powellb1/CapStone/Documentation/Class Presentations/Design Presentation/photo 1.jpg

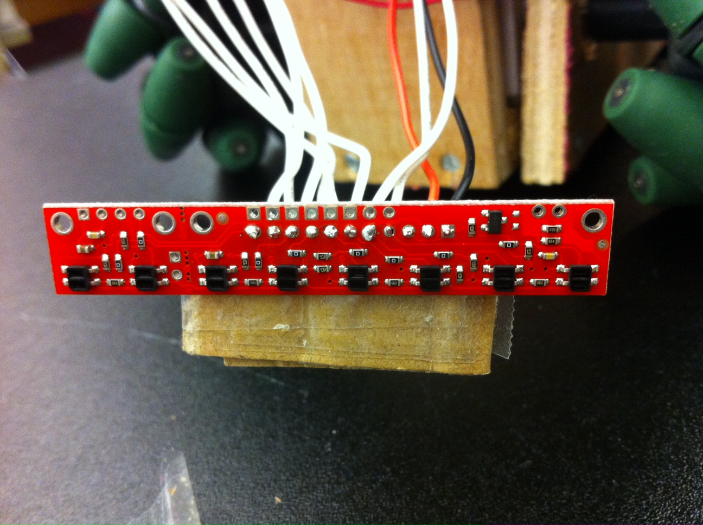
Documentation/Class Presentations/Design Presentation/photo 1.jpg
