powellb1/CapStone/Documentation/Class Presentations/Design Presentation/photo 2.jpg

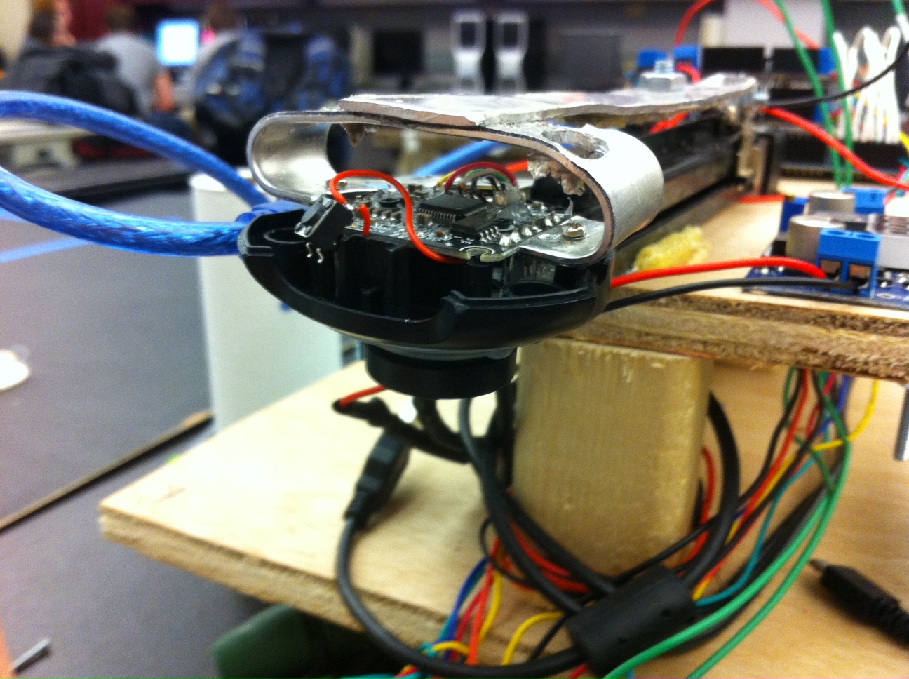
Documentation/Class Presentations/Design Presentation/photo 2.jpg
