powellb1/CapStone/README.md

CapStone
This is a test to see what happens on GitHub.
This is a test to see what happens on Brian's branch
========
