powellb1/CapStone/.c9/metadata/workspace/README.md

{"changed":true,"filter":false,"title":"README.md","tooltip":"/README.md","value":"CapStone\nThis is a test to see what happens on GitHub.\nThis is a test to see what happens on Brian's branch\nMore changes to the branch.\n========\n","undoManager":{"mark":72,"position":100,"stack":[[{"group":"doc",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
{"row":3,"column":15}},"text":"o"}]}],[{"group":"doc","deltas":[{"action":"insertText","range":{"start":{"row":3,"column":15},"end":{"row":3,"column":16}},"text":" "}]}],[{"group":"doc","deltas":[{"action":"insertText","range":{"start":{"row":3,"column":16},"end":{"row":3,"column":17}},"text":"t"}]}],[{"group":"doc","deltas":[{"action":"insertText","range":{"start":{"row":3,"column":17},"end":{"row":3,"column":18}},"text":"h"}]}],[{"group":"doc","deltas":[{"action":"insertText","range":{"start":{"row":3,"column":18},"end":{"row":3,"column":19}},"text":"e"}]}],[{"group":"doc","deltas":[{"action":"insertText","range":{"start":{"row":3,"column":19},"end":{"row":3,"column":20}},"text":" "}]}],[{"group":"doc","deltas":[{"action":"insertText","range":{"start":{"row":3,"column":20},"end":{"row":3,"column":21}},"text":"b"}]}],[{"group":"doc","deltas":[{"action":"insertText","range":{"start":{"row":3,"column":21},"end":{"row":3,"column":22}},"text":"r"}]}],[{"group":"doc","deltas":[{"action":"insertText","range":{"start":{"row":3,"column":22},"end":{"row":3,"column":23}},"text":"a"}]}],[{"group":"doc","deltas":[{"action":"insertText","range":{"start":{"row":3,"column":23},"end":{"row":3,"column":24}},"text":"n"}]}],[{"group":"doc","deltas":[{"action":"insertText","range":{"start":{"row":3,"column":24},"end":{"row":3,"column":25}},"text":"c"}]}],[{"group":"doc","deltas":[{"action":"insertText","range":{"start":{"row":3,"column":25},"end":{"row":3,"column":26}},"text":"h"}]}],[{"group":"doc","deltas":[{"action":"insertText","range":{"start":{"row":3,"column":26},"end":{"row":3,"column":27}},"text":"."}]}]]},"ace":{"folds":[],"scrolltop":0,"scrollleft":0,"selection":{"start":{"row":3,"column":27},"end":{"row":3,"column":27},"isBackwards":false},"options":{"guessTabSize":true,"useWrapMode":false,"wrapToView":true},"firstLineState":0},"timestamp":1410190207259}
