powellb1/CapStone/Documentation/Class Presentations/Are We There Yet Progress Report 5.pptx

## Are We There Yet

Progress Report 5

## Tasks Completed

- Post Mortem 3
- Sprint 4 Backlog
- Budget

## Currently Working On

- Prototyping

## Looking Ahead

- Prototype testing
- Prototype II
- Level 2 Requirements

## Prototype I

- Alex S. line following sensors
- Brian P. item detection with the camera
- Brian S. arm design and movement
- Michael P. Etch-A-Sketch software
