powellb1/CapStone/Documentation/Class Presentations/Are We There Yet Progress Report 4.pptx

## Are We There Yet

Progress Report 4

## Tasks Completed

- Post Mortem 2
- Sprint 3 Backlog
- Parts and design research

## Currently Working On

- Final Parts List and Budget
- Initial prototyping
- Parts order

## Current System Design

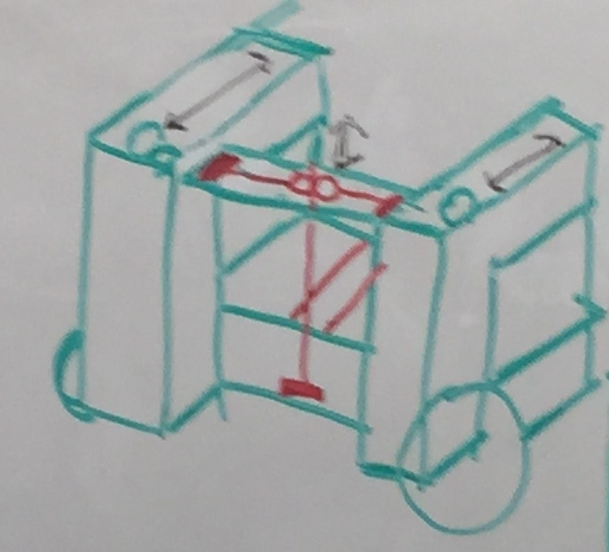
[picture p30: figure]

## Looking Ahead

- Parts Order
- Prototype
- Prototype testing
- Level 2 Requirements

## Major Budget Items

- Udoo Microcontroller
- Mecanum Wheels
- Stepper and gear motors
- Linear actuators
- Camera
- Chassis
- Batteries
