powellb1/CapStone/Documentation/Class Presentations/Are We There Yet Progress Report 4 Revision.pptx

## Are We There Yet

Progress Report 4

## Tasks Completed

- Post Mortem 2
- Sprint 2
- Budget
- Parts and design research

## Currently Working On

- Final Parts List
- Initial prototyping
- First parts order
  - Determine what we will prototype first

## Looking Ahead

- Parts Order
- Prototyping
- Prototype testing
- Level 2 Requirements

## Major Budget Items

- Udoo Microcontroller
- Mecanum Wheels
- Stepper and gear motors
- Linear actuators
- Camera
- Chassis
- Batteries
