powellb1/CapStone/Documentation/Class Presentations/Are We There Yet Progress Report 2.pptx

## Are We There Yet?

Progress Report #2

## Requirements Document Update

- SRS from initial review
- Items needing clarification:
  - Details on challenge completion

Notes: Challenge obstruction is a design consideration.

## Requirement Changes

- Initial Requirement
  - The system shall operate for a minimum of three consecutive course rounds each having duration of five (5) minutes, on one battery life.
- Edited Requirement
  - The system shall operate on one battery life for a minimum of three consecutive course rounds, each having duration of five (5) minutes.

## Requirements Needing Refinement

    - The system shall track its movement along the Scotch Blue Painter’s tape.
    - The system shall respond to the last color in the Simon within [TBD] amount of time.

## Next Steps

- Further research into design
  - Control boards
  - Overall system design
  - Method of challenge completion
- Specific parts research

## Questions?
