powellb1/CapStone/Documentation/Class Presentations/2014 SECON Competition Proposal.pptx

## 2014 SECON Competition Proposal

Are We There Yet? (AWTY)
Brian Sterling
Brian Powell
Alex Senopoulos
Michael Philotoff

## Competition Outline

- Line Following
- Simon Says (15 Seconds)
- Etch-A-Sketch (Draw IEEE)
- Rubik’s Cube (Rotate one side 180 degrees)
- Card Pick-up (Carry to end of course)

## Control System

- Arduino Mega
- Beaglebone Black
- Cortex Stellaris

Notes: Cortex line has a ton of pins on it along with around 4GB of onboard memory compared to the Arduino’s 128KB. We weren’t finding too much on the cortex products along with their respective IDEs. Beaglebone cloud 9 ide

## Movement System

- Tank treads*
- Wheels

Notes: Treads will allow for rotation without forward movement which will be helpful. It also allows for no worry about excess movemnt after motor stop. The resistance will halt it.

## Line Following

- Photo Resistors for recognition of line

## Simon Says

- Color Recognition
- Light Recognition
- Sound

Notes: Sound is probably going to be unreliable. Not safe to make that a primary method.

## Etch-A-Sketch

- Claws to manipulate knobs
- Cap to fit over knob in order to manipulate

## Rubik’s Cube

- Utilize same claw system as the etch-a sketch
- Attempt to leave on ground and manipulate top row

## Card Pick-Up

- Use of sticky tack or other adhesive substance
- Use of suction

Notes: Adhesive involves less manipulation on robots part.

## Initial Budget Estimate

- Claws: $40.00
- Microcontroller: $40.00 – $70.00
- Treads: $60.00
- Chassis: $50.00
- Arms: $60.00
- Motors : $10.00 per motor, approx.10-15 motors

Notes: $410. Conservative price

## Considerations

- Group Strengths
  - Line Following
  - Experience using microcontrollers and a variety of IDEs.
- Challenges
  - Exploration and learning of new topics/ideas, specifically the color/light recognition.
- Fall Goals
  - Etch-A-Sketch and Simon Says implemented

Notes: Brian got da experience line following. Good idea for it. Color recognition for the simon says is going to be a bigger challenge. Line Following will be continually looked at.
