powellb1/CapStone/Documentation/Class Presentations/Design Presentation/AWTY - Design Presentation.pptx

## Team Are We There Yet

Design Presentation

## Introduction

- Project Mission
  - Play the game “Simon” for 15 seconds
  - Pick up a playing card and carry it across the finish line
  - Twist one row of a Rubik’s cube 180 degrees
  - Draw “IEEE” on an Etch-A-Sketch
  - Line follow
  - Complete round in 5 minutes or less

## Competition Course


## Timeline

- 18 September 2014 – Preliminary Requirements
- 10 October 2014 – Preliminary Budget
- 18 November 2014 – Integrated Prototype
- 25 November 2014 – Revised Requirements
- 12 December 2014 – Preliminary Design Document

## Budget

- Proposed budget: $654.52
- Total spent: $560.21

## Design Solution

- Process
  - Identify when light in starting area goes out
  - Line follow to first challenge
  - Complete challenge
  - Line follow to second, third and fourth challenges, completing each
  - Cross finish line

## System Architecture


## Design Considerations

- Assumptions and dependencies
  - Operation
  - Rule changes
- General Constraints
  - Size
  - Power consumption
- Safety Constraints and Considerations
  - Electrical hazards
  - System heating

## Subsystems

- Coordination Subsystem
  - Reads input from sensors
  - Directs other subsystems
- Movement Subsystem
  - Contains all components responsible for moving system
- Challenge Subsystem
  - Contains all components responsible for completing challenges

## Coordination Subsystem

- Purpose
  - Progresses system through state diagram
  - “Master” of system
- Responsibilities
  - Read input from sensors
  - Interpret sensor reading
  - Activate corresponding subsystem


## Functional Diagram


## Parts List

- Raspberry Pi B+
- Arduino Mega 2560
- QTR-8A Line Sensor Array
- USB Camera
- Ultrasonic Sensor

## Movement Subsystem

- Purpose and Responsibility
  - Performs all movement operations
    - Motors and wheels
    - Chassis
- Constraints
  - Fit within starting area
  - Maintain contact with course floor

## Functional Diagram


## Parts List

## Chassis

- 2 tiers
- (weight)
- (dimensions)

## Motors

- Motor stuff

## Wheels

- Wheel stuff

## Battery

- Battery stuff

## Challenge Subsystem

## Functional Diagram


## Parts List

## Simon Interactor

- Information about interactor

## Rubik’s Cube and Card Interactor

- Information about interactor

## Etch-A-Sketch Interactor

- Information about interactor

## Video of Performance

## Semester Re-cap

- Accomplishments
- Goals for next semester
