powellb1/CapStone/Documentation/Budget/Motors Refernces and Pictures.docx

References

1) Introduction to Stepper Motors. (n.d.). Retrieved October 6, 2014, from http://www.omega.com/prodinfo/stepper_motors.html
2) RobotShop | Robot Store | Robots | Robot Parts | Robot Kits ... (n.d.). Retrieved October 1, 2014.
3) SparkFun Electronics. (n.d.). Retrieved September 29, 2014.
4) Firgelli Technologies - Micro Linear Actuators. (n.d.). Retrieved October 3, 2014.
5) Stepper motor|Stepping gearmotor wholesale|Stepping motor ... (n.d.). Retrieved October 2, 2014.

Images

Soyo SY42STH38-0406B Unipolar Stepper Motor

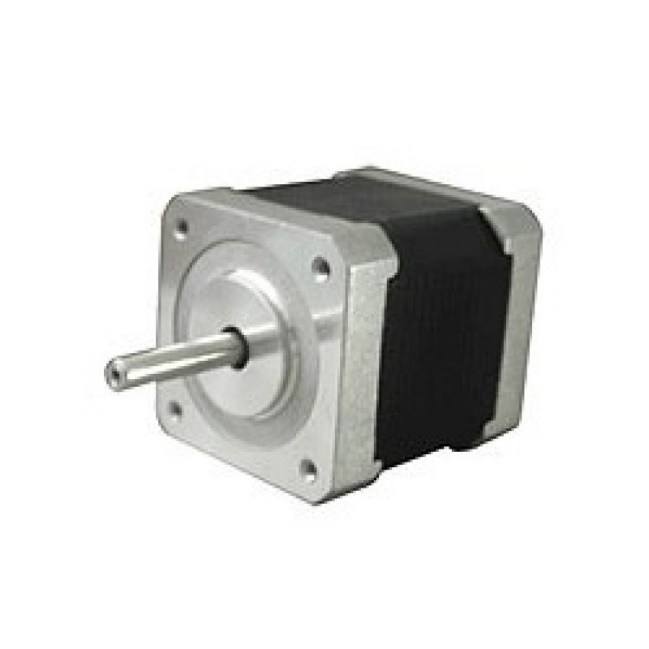
[picture p53: figure]
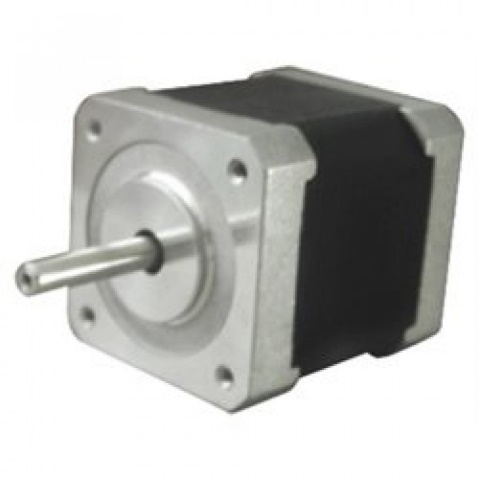
[picture p54: figure]

Soyo SY42STH47-1684MB RepRap Stepper Motor

Wantai 42BYGHM809

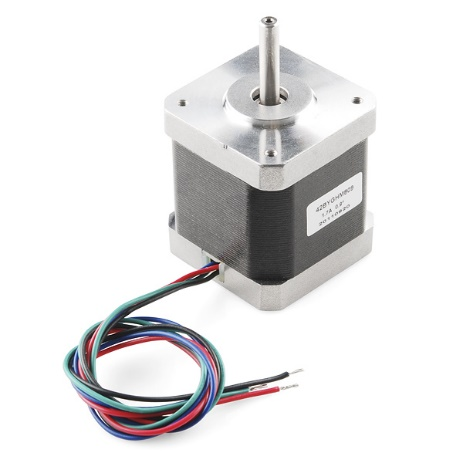
[picture p55: figure]
Stepper Motor - 68 oz.in (400 steps/rev)

Wantai 57BYGH420

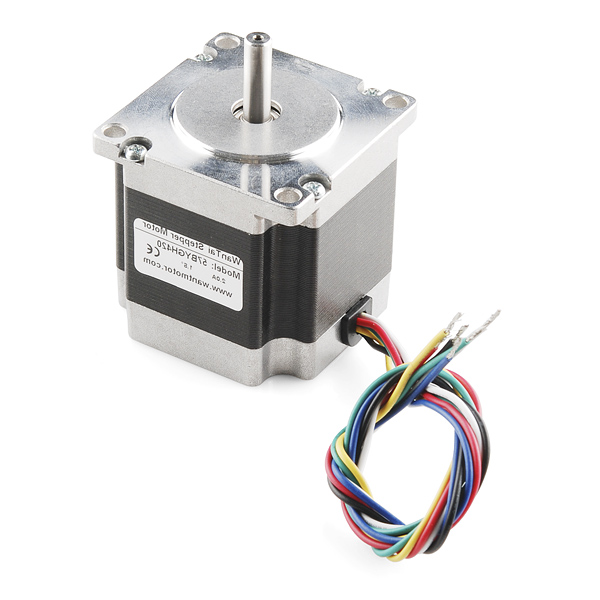
[picture p56: figure]
Stepper Motor - 125 oz.in (200 steps/rev)

Micro Metal Gearmotor 30:1 Shenzen Kenmore KM-12FN20-30-06430

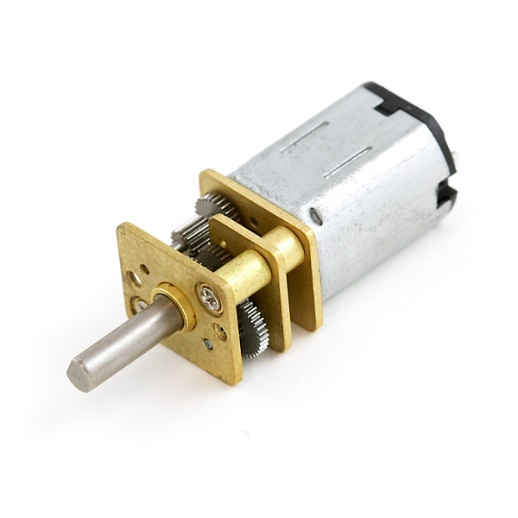
[picture p57: figure]
Micro Metal Gearmotor 30:1

Micro Gearmotor ROB-12285

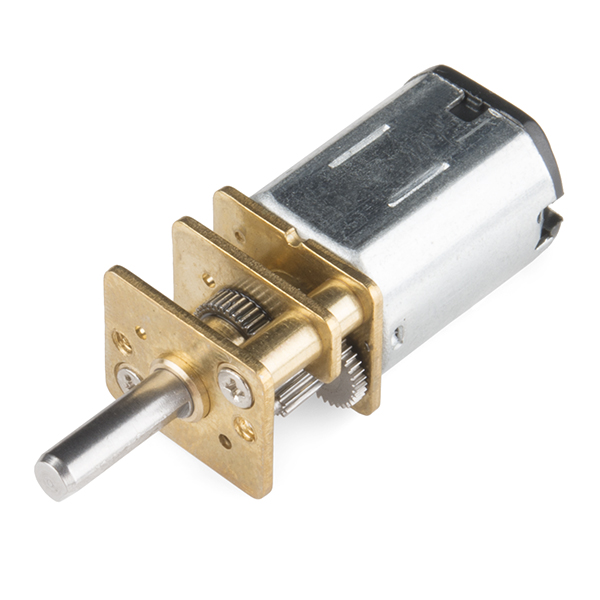
[picture p58: figure]
Micro Gearmotor - 90 RPM (6-12V)

Cytron 12V 12RPM 166oz-in Spur Gearmotor

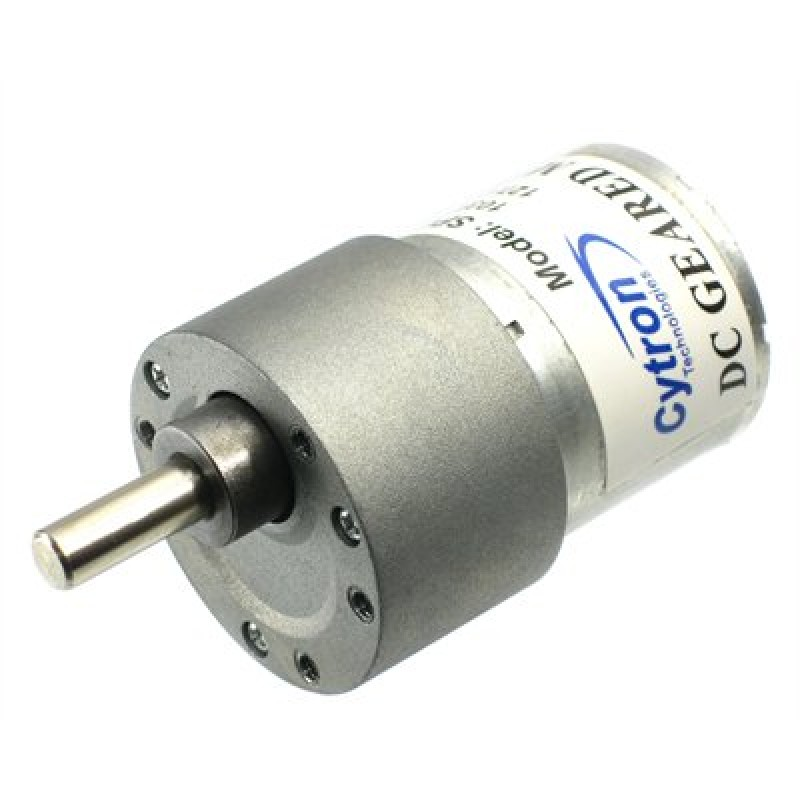
[picture p59: figure]

Firgelli Technologies L12 Actuator 50mm 210:1 12V Limit Switch

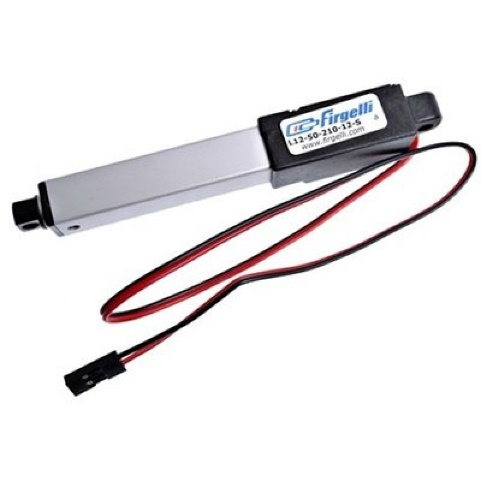
[picture p60: figure]

Firgelli Technologies L12 Actuator 100mm 100:1 12V Limit Switch

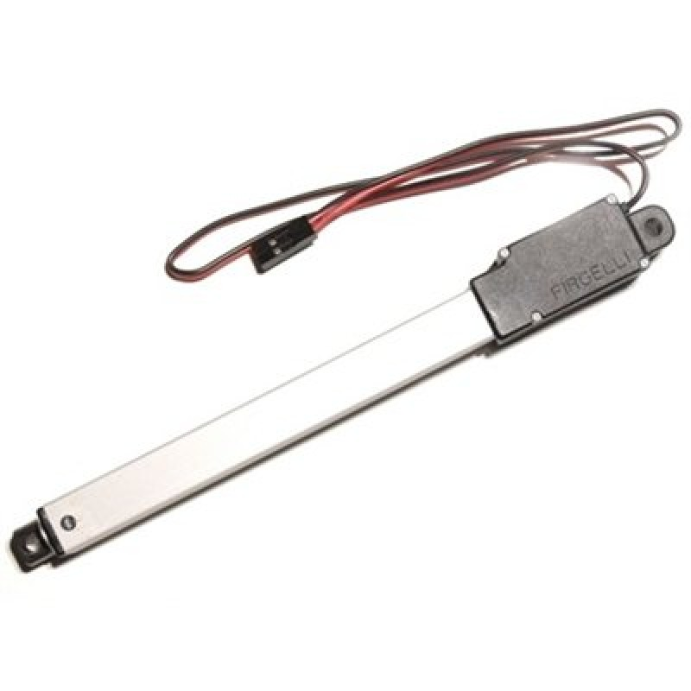
[picture p61: figure]

Firgelli Technologies L16 Linear Actuator, 140mm, 35:1, 12V w/ Limit Switches

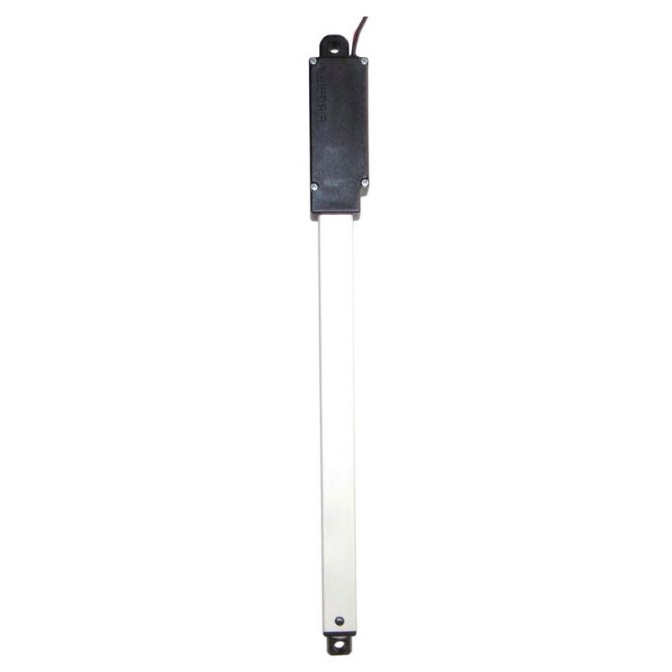
[picture p62: figure]
