powellb1/CapStone/Documentation/Class Presentations/Design Presentation/IMG_1001.jpg

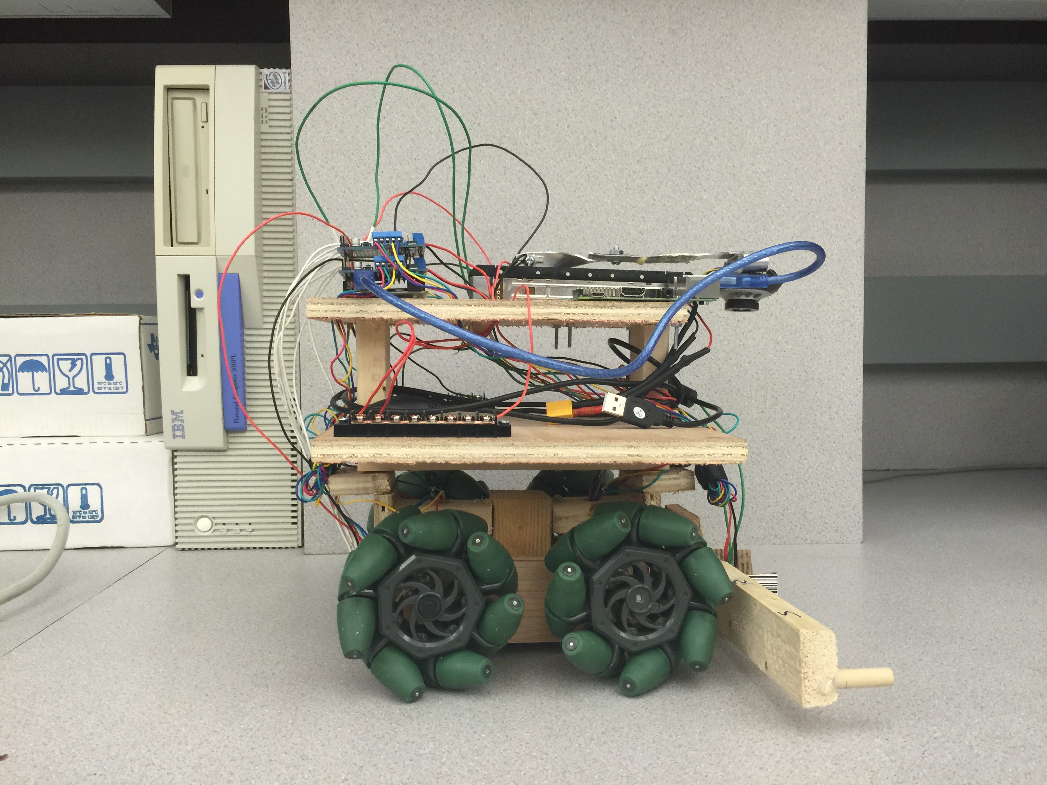
Documentation/Class Presentations/Design Presentation/IMG_1001.jpg
