powellb1/CapStone/Documentation/Class Presentations/Design Presentation/IMG_1002.jpg

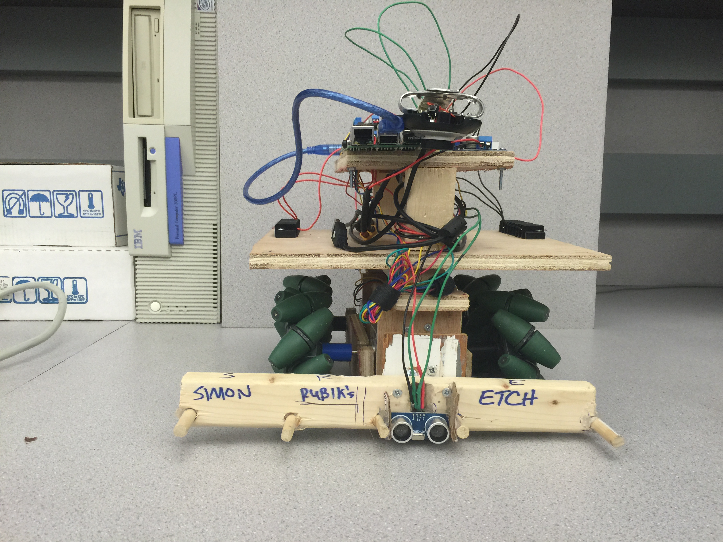
Documentation/Class Presentations/Design Presentation/IMG_1002.jpg
