powellb1/CapStone/Documentation/Class Presentations/Design Presentation/photo 3.jpg

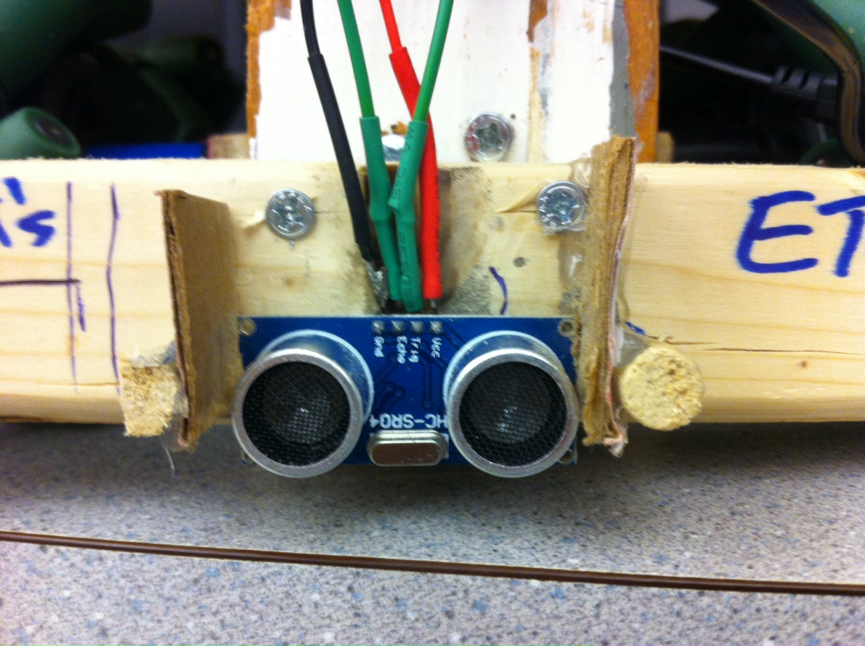
Documentation/Class Presentations/Design Presentation/photo 3.jpg
