powellb1/CapStone/Documentation/Design Drafts/RoadieDesignARev1 001.jpg

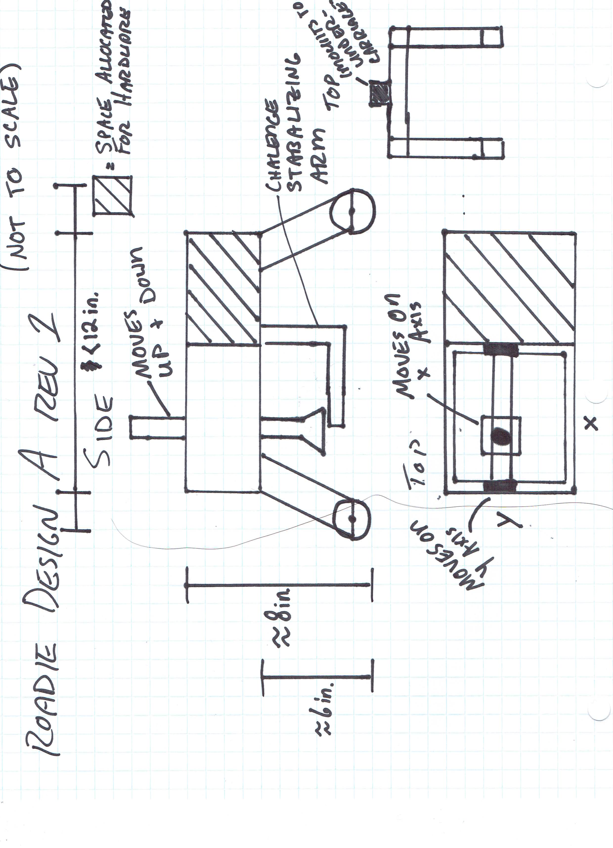
Documentation/Design Drafts/RoadieDesignARev1 001.jpg
