powellb1/CapStone/Documentation/Design Drafts/RoadieDesignBRev1 001.jpg

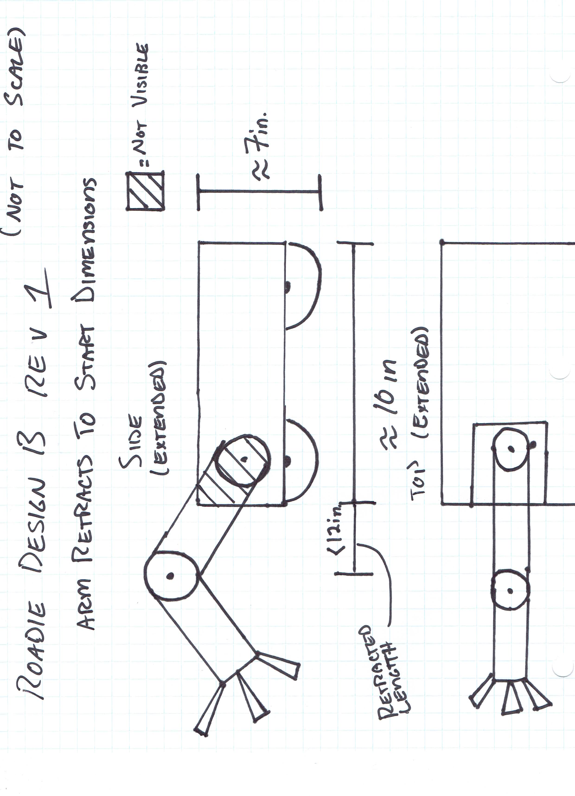
Documentation/Design Drafts/RoadieDesignBRev1 001.jpg
