powellb1/CapStone/Documentation/Budget/Parts Order.xlsx

Item | URL | Vendor | Item Price | Item Quantity | Shipping | Total
Udoo Quad | http://shop.udoo.org/usa/?___from_store=usa&popup=no | Udoo | $135 | 1 | $11.00 | $146.00
Mechanum Wheels | http://www.vexrobotics.com/276-1447.html | Vex Robotics | $59.99 | 1 | 11.72 | $71.71
Venom 800mAh LiPo | http://www.amazon.com/Venom-800mAh-LiPO-Battery-Plug/dp/B0027GEY3Y | Amazon | $13.99 | 1 |  | $13.99
Fosmon USB 6 LED Webcam | http://www.amazon.com/Fosmon-Webcam-Camera-Meeting-compatible/dp/B008GWPC1Q |  | $7.99 | 1 |  | $7.99
Venom 5000mAh LiPo | http://www.amazon.com/Venom-5000mAh-14-8-LiPO-Battery/dp/B0027G9F9M |  | $79.43 | 1 |  | $79.43
Firgelli 50mm Minature Linear Actuator | http://www.robotshop.com/en/firgelli-technologies-l12-actuator-50mm-210-1-6v-limit-switch.html | Robotshop | $70.00 | 2 | $9.00 | $149.00
Micro Gearmotor ROB-12285 | https://www.sparkfun.com/products/12285 | Sparkfun | $12.95 | 3 |  | $38.85
Wantai 42BYGHM80 Stepper Motor | https://www.sparkfun.com/products/10846 |  | $16.95 | 4 |  | $67.80
QRE1113 | https://www.sparkfun.com/products/9454 |  | $2.95 | 5 |  | $14.75
LiPo Fuel Gauge | https://www.sparkfun.com/products/10617 |  | $9.95 | 2 |  | $19.90
EasyDriver Stepper Motor Driver | https://www.sparkfun.com/products/10267 |  | $14.95 | 1 |  | $14.95
 |  |  |  |  | Total | $624.37
