powellb1/CapStone/Documentation/Budget/Final Budget.xlsx

Item | Vendor | Backup Vendor | Price | Quantity | Shipping Cost | Replacement Cost | Total
Udoo Quad | Udoo Shop |  | $135.00 | 1 | $11.00 |  | $146.00
Mechanum Wheels (4) | VEXRobotics |  | $59.99 | 1 | $11.72 |  | $71.71
QRE1113 (Digital) | SparkFun |  | $2.95 | 5 | $0.00 |  | $14.75
Venom 800mAh LiPo | Amazon |  | $13.99 | 1 | $0.00 |  | $13.99
Fosmon USB 6 LED Webcam | Amazon |  | $7.99 | 1 | $0.00 |  | $7.99
Custom Chassis | N/A |  | $25.00 | 1 | $0.00 |  | $25.00
Custom Claw | N/A |  | $40.00 | 1 | $0.00 |  | $40.00
Firgelli 50mm Miniature Linear Actuator | Robot Shop | Firgeli | $70.00 | 2 | $9.00 |  | $149.00
Micro Gearmotor ROB-12285 | SparkFun |  | $12.95 | 3 | $0.00 |  | $38.85
Wantai 42BYGHM80 Stepper Motor | SparkFun | Wantmotors | $16.95 | 4 | $0.00 |  | $67.80
Venom 5000 mAh LiPo | Amazon |  | $79.43 | 1 | $0.00 |  | $79.43
 |  |  |  |  |  | Total: | $654.52
