powellb1/CapStone/3D Parts/Wheel_cap_extended.stl

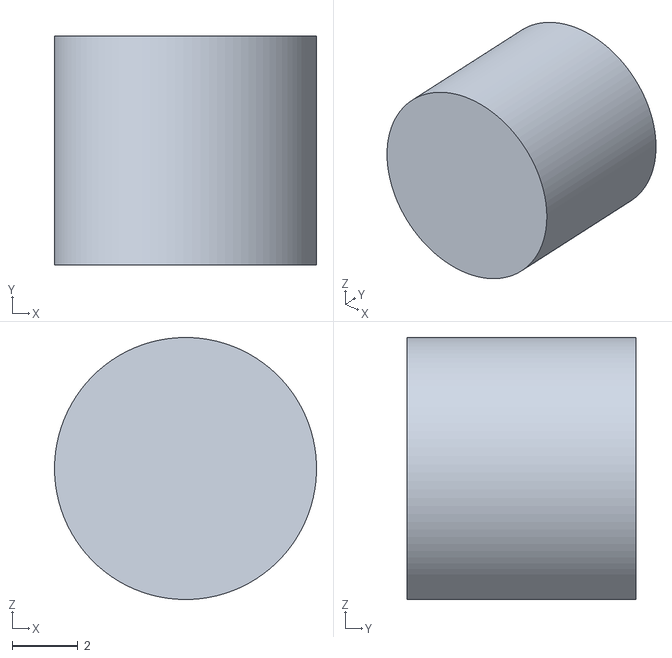
[picture p75: CAD file, 2014-12-03]
3D Parts/Wheel_cap_extended.stl
8.00 x 7.00 x 8.00
