powellb1/CapStone/3D Parts/Part1.stl

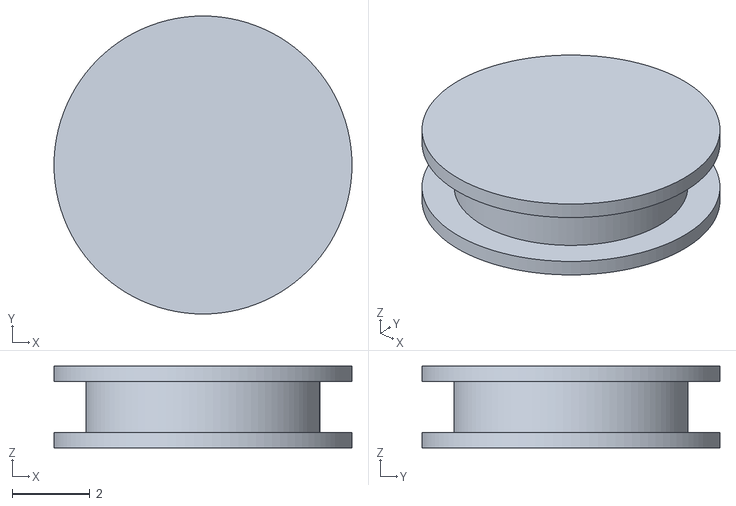
[picture p76: CAD file, 2014-11-17]
3D Parts/Part1.stl
7.65 x 7.65 x 2.10
