powellb1/CapStone/3D Parts/Wheel_Coupler_2.stl

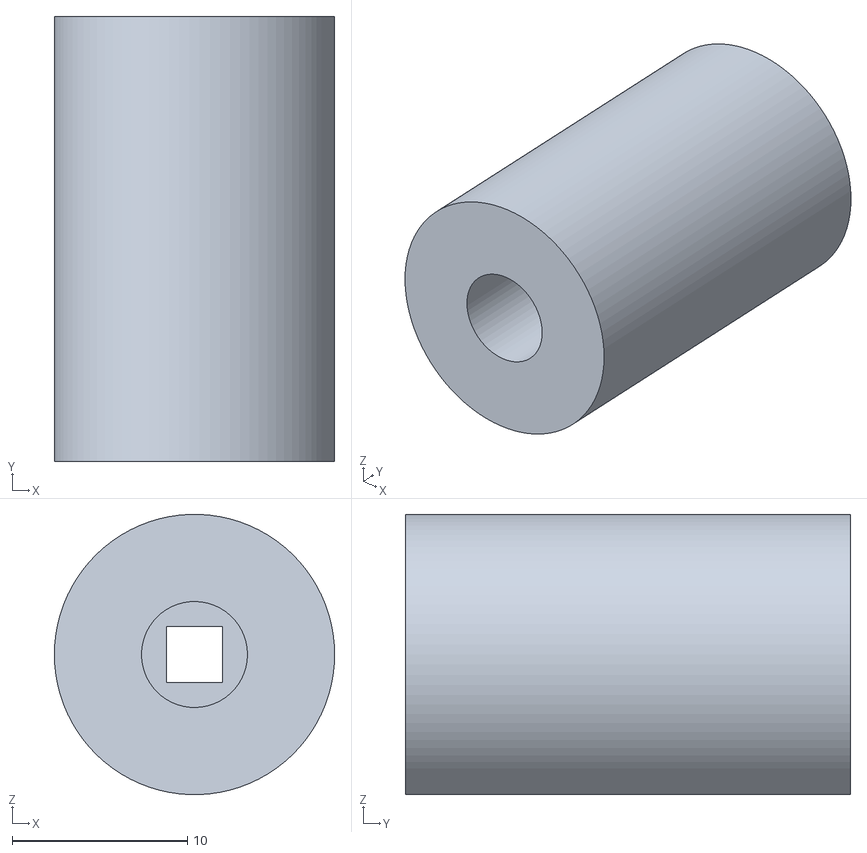
[picture p77: CAD file, 2014-11-14]
3D Parts/Wheel_Coupler_2.stl
16.0 x 25.4 x 16.0
