powellb1/CapStone/3D Parts/Wheel_cap.stl

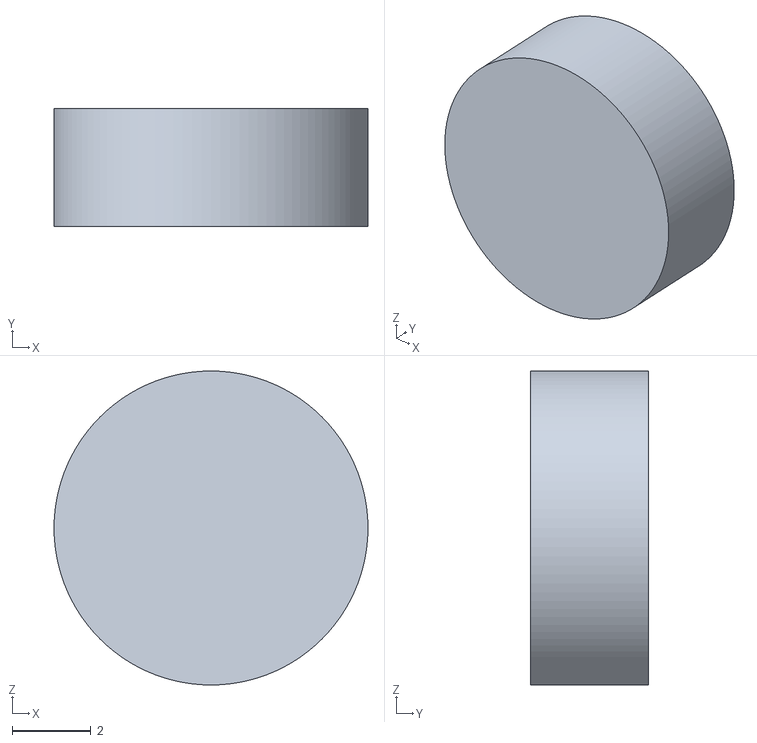
[picture p78: CAD file, 2014-11-10]
3D Parts/Wheel_cap.stl
8.00 x 3.00 x 8.00
