powellb1/CapStone/3D Parts/Wheel_Coupler.stl

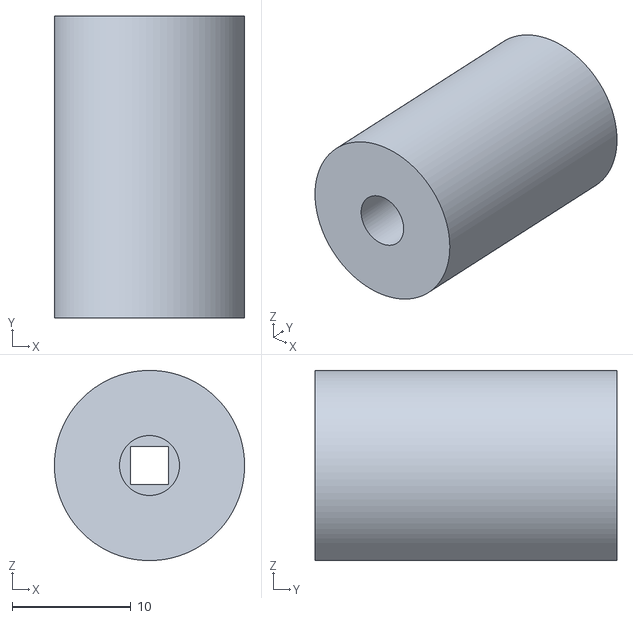
[picture p79: CAD file, 2014-11-10]
3D Parts/Wheel_Coupler.stl
16.0 x 25.4 x 16.0
