powellb1/CapStone/(list of files, cad)

Other CAD files:
3D Parts/OldVersions/Wheel_Coupler.0006.ipt
3D Parts/OldVersions/Wheel_cap.0003.ipt
3D Parts/OldVersions/Wheel_cap_extended.0001.ipt
3D Parts/Part1.ipt
3D Parts/Wheel_Coupler.dwg
3D Parts/Wheel_Coupler.ipt
3D Parts/Wheel_cap.ipt
3D Parts/Wheel_cap_extended.ipt
