powellb1/CapStone/Documentation/Design Documents/Movement-Misc_TestCases.xlsx

Project Name:
Test Case ID: |  |  |  | Test Design By: Alex Senopoulos
Test Priority: Low |  |  |  | Test Designed Date: November 29, 2014
Module Name: Movement |  |  |  | Test Excuted By:
Test Title: Sizing |  |  |  | Test Excution Date:
Description: Confirm size requirements for Roadie
Pre-conditions: Roadie will be motionless with it's camera retracted.
Requirement Satisfied: MOV 1
Step | Test Steps | Test Data | Expected Result | Actual Result | Status(Pass/Fail) | Notes
1 | Leave Roadie motionless
2 | Measure dimensions | Width/Length/Height | Within 1ft.x1ft.x1ft.
Post-conditions: Roadie will remain motionless
Test Case ID: |  |  |  | Test Design By: Alex Senopoulos
Test Priority: High |  |  |  | Test Designed Date: November 29, 2014
Module Name: Movement |  |  |  | Test Excuted By:
Test Title: Roadie stress test |  |  |  | Test Excution Date:
Description: Test life of Roadie's power to ensure at least 30 minute lifespan
Pre-conditions: Roadie will start suspended with no wheel contact on ground and a full battery charge. Modified code uploaded to keep motors and sensors coninually running.
Requirement Satisfied: MOV 2
Step | Test Steps | Test Data | Expected Result | Actual Result | Status(Pass/Fail) | Notes
1 | Suspend Roadie in place
2 | Run all subRoadies at normal operating capacity
3 | Measure time until noticible deterioration of wheel speed | Time (minutes) | Greater than 30 minutes
Post-conditions: Roadie power source will have a less than nominal charge.
Test Case ID: |  |  |  | Test Design By: Alex Senopoulos
Test Priority: Low |  |  |  | Test Designed Date: November 29, 2014
Module Name: Movement |  |  |  | Test Excuted By:
Test Title: Power switch |  |  |  | Test Excution Date:
Description: Ensure Roadie has easily accessible power switch
Pre-conditions: Roadie will be powered off at the starting area.
Requirement Satisfied: MOV 3
Step | Test Steps | Test Data | Expected Result | Actual Result | Status(Pass/Fail) | Notes
1 | Use power switch to provide power to Roadie |  | Roadie will receive power
Post-conditions: Roadie will have power and execute loaded Arduino instructions.
Test Case ID: |  |  |  | Test Design By: Alex Senopoulos
Test Priority: Medium |  |  |  | Test Designed Date: November 29, 2014
Module Name: Movement |  |  |  | Test Excuted By:
Test Title: Surface Contact |  |  |  | Test Excution Date:
Description: Ensure Roadie remains in contact with competition surface
Pre-conditions: Roadie will be un-powered at starting area
Requirement Satisfied: MOV 4, MOV 5
Step | Test Steps | Test Data | Expected Result | Actual Result | Status(Pass/Fail) | Notes
1 | Turn on Roadie
2 | Observe Roadie's exection of the competition from start to finish. |  | Roadie remains in contact with competition surface.
Post-conditions: Roadie is motionless at the finish line.
Test Case ID: |  |  |  | Test Design By: Alex Senopoulos
Test Priority: High |  |  |  | Test Designed Date: November 29, 2014
Module Name: Movement |  |  |  | Test Excuted By:
Test Title: Minimum oscillation line following |  |  |  | Test Excution Date:
Description: Ensure Roadie can efficiently follow straight guidance tape.
Pre-conditions: Roadie will be in a line following state with it's sensor array over straight guidance tape.
Requirement Satisfied:
Step | Test Steps | Test Data | Expected Result | Actual Result | Status(Pass/Fail) | Notes
1 | Allow Roadie to run continuously along guidance tape. |  | Roadie will keep guidance tape within the bounds of its own wheels.
Post-conditions: Roadie will arrive at the end of the guidance tape and have the tape between the bounds of the Roadie's wheels.
Test Case ID: |  |  |  | Test Design By: Alex Senopoulos
Test Priority: High |  |  |  | Test Designed Date: November 29, 2014
Module Name: Movement |  |  |  | Test Excuted By:
Test Title: Right turn |  |  |  | Test Excution Date:
Description: Ensure Roadie can navigate a right turn correctly
Pre-conditions: Roadie will approach a right turn in the guidance tape while in the line following state.
Requirement Satisfied:
Step | Test Steps | Test Data | Expected Result | Actual Result | Status(Pass/Fail) | Notes
1 | Roadie approaches right turn with sensors over guidance tape
2 | Roadie rotates leaves line following state and turns right 90 degrees | Angle of Roadie relative to new section of guidance tape | 10 degree margin of error
3 | Roadie resumes line following state
Post-conditions: Roadie will be in a line following state navigating along the guidance tape.
Test Case ID: |  |  |  | Test Design By: Alex Senopoulos
Test Priority: High |  |  |  | Test Designed Date: November 29, 2014
Module Name: Movement |  |  |  | Test Excuted By:
Test Title: Left turn |  |  |  | Test Excution Date:
Description: Ensure Roadie can navigate a left turn correctly
Pre-conditions: Roadie will approach a left turn in the guidance tape while in the line following state.
Requirement Satisfied:
Step | Test Steps | Test Data | Expected Result | Actual Result | Status(Pass/Fail) | Notes
1 | Roadie approaches left turn with sensors over guidance tape
2 | Roadie rotates leaves line following state and turns 90 degrees left | Angle of Roadie relative to new section of guidance tape | 10 degree margin of error
3 | Roadie resumes line following state
Post-conditions: Roadie will be in a line following state navigating along the guidance tape.
Test Case ID: |  |  |  | Test Design By: Alex Senopoulos
Test Priority: Medium |  |  |  | Test Designed Date: November 29, 2014
Module Name: Movement |  |  |  | Test Excuted By:
Test Title: Roadie veer too far right |  |  |  | Test Excution Date:
Description: Roadie corrects movement for being off the line too far to the right
Pre-conditions: Roadie is in the line following state with the two left most sensors over the guidance tape and the sensor array front facing away from the guidance tape.
Requirement Satisfied:
Step | Test Steps | Test Data | Expected Result | Actual Result | Status(Pass/Fail) | Notes
1 | Roadie adjusts right side motor speed to a larger value than the left side | Motor rpm values for each wheel | Right side motors = 5000, Left side motors = 2000
Post-conditions: Roadie's sensor array front will be facing towards the line
Test Case ID: |  |  |  | Test Design By:
Test Priority: |  |  |  | Test Designed Date:
Module Name: |  |  |  | Test Excuted By:
Test Title: |  |  |  | Test Excution Date:
Description:
Pre-conditions:
Requirement Satisfied:
Step | Test Steps | Test Data | Expected Result | Actual Result | Status(Pass/Fail) | Notes
Post-conditions:
Test Case ID: |  |  |  | Test Design By:
Test Priority: |  |  |  | Test Designed Date:
Module Name: |  |  |  | Test Excuted By:
Test Title: |  |  |  | Test Excution Date:
Description:
Pre-conditions:
Requirement Satisfied:
Step | Test Steps | Test Data | Expected Result | Actual Result | Status(Pass/Fail) | Notes
Post-conditions:
