powellb1/CapStone/Documentation/Design Documents/Coordination_TestCases.xlsx

Project Name:
Test Case ID: |  |  |  | Test Design By: Michael Philotoff
Test Priority: High |  |  |  | Test Designed Date: November 30, 2014
Module Name: |  |  |  | Test Excuted By:
Test Title: Idenfiting challenge in 10 seconds |  |  |  | Test Excution Date:
Description: Idenfity a challenge once arriving to that challenge zone within 10 seconds
Pre-conditions: Roadie arrives at a challenge zone
Requirement Satisfied: COR 6 and COR 6.1
Step | Test Steps | Test Data | Expected Result | Actual Result | Status(Pass/Fail) | Notes
1 | Turn on the ultra sonic |  | Ultra sonic operational
2 | Detect an object within 4 inches of Roadie | Object Detected | Detects an object
3 | Turns the camera on |  | Camera is operational
4 | Camera idenfitys the challenge within 5 seconds | Object Identification | Camera idenfities the object
Post-conditions: Idenfitys the challenge present infront of Roadie
Project Name:
Test Case ID: |  |  |  | Test Design By: Michael Philotoff
Test Priority: High |  |  |  | Test Designed Date: November 30, 2014
Module Name: |  |  |  | Test Excuted By:
Test Title: Rubik's Cube Identification and Alignment |  |  |  | Test Excution Date:
Description: Roadie correctly idenfities the challenge Rubik's Cube within 5 seconds of the camera being turn on. Then Roaide algins itself up with Rubik's Cube.
Pre-conditions: Roadie has arrvied at a challenge zone and has detected a challenge within 4 inches of Roadie
Requirement Satisfied: COR 6.3, COR 7, and COR 7.1
Step | Test Steps | Test Data | Expected Result | Actual Result | Status(Pass/Fail) | Notes
1 | Camera identifies Rubik's Cube |  | Rubik's Cube is identified
2 | Camera measures the distance between | Pixels convereted to inches | Distance measured
3 | Strafe the distance measured by the Camera |  | Roadie strafes
4 | Roadie moves forward 4 inches |  | Roadie moves forward
5 | Roadie signles that it has arrived at the challenge |  | Roadie is at the Rubik's Cube
Post-conditions: Roadie has aligned with the challenge and signles that it has arrived.
Project Name:
Test Case ID: |  |  |  | Test Design By: Michael Philotoff
Test Priority: High |  |  |  | Test Designed Date: November 30, 2014
Module Name: |  |  |  | Test Excuted By:
Test Title: Correctly Idenfity Simon Carabiner |  |  |  | Test Excution Date:
Description: Roadie correctly idenfities the challenge Simon Carabiner within 5 seconds of the camera being turn on. Then Roaide algins itself up with Simon Carabiner.
Pre-conditions: Roadie has arrvied at a challenge zone and has detected a challenge within 4 inches of Roadie
Requirement Satisfied: COR 6.2, COR 7, and COR 7.1
Step | Test Steps | Test Data | Expected Result | Actual Result | Status(Pass/Fail) | Notes
1 | Camera idenfities Simon Carabiner |  | Simon Carabiner is identified
2 | Camera measures the distance between Simon Carabiner and Roadie | Pixels convereted to inches | Distance measured
3 | Strafe this distance measured from the Camera |  | Roadie strafes
4 | Roadie moves forwards 4 inches |  | Roadie moves forward
5 | Roadie signles that it has arrived at the challenge |  | Roadie is at the Simon Carabiner
Post-conditions: Roadie has alligned with the challenge and signles that it has arrived at the challenge.
Project Name:
Test Case ID: Etch-A-Sketch Idenfitication and Algiment |  |  |  | Test Design By: Michael Philotoff
Test Priority: High |  |  |  | Test Designed Date: November 30, 2014
Module Name: |  |  |  | Test Excuted By:
Test Title: Correctly Idenfity Etch-A-Sketch |  |  |  | Test Excution Date:
Description: Roadie correctly idenfities the challenge Etch-A-Sketch within 5 seconds of the camera being turn on. Then Roaide algins itself up with Etch-A-Sketch.
Pre-conditions: Roadie has arrvied at a challenge zone and has detected a challenge within 4 inches of Roadie
Requirement Satisfied: COR 6.4, COR 7, and COR 7.1
Step | Test Steps | Test Data | Expected Result | Actual Result | Status(Pass/Fail) | Notes
1 | Camera idenfities Etch-A-Sketch |  | Etch-A-Sketch is identified
2 | Camera measures the distance | Pixels convereted to inches | Distance measured
3 | Strafe the distance measured from the Camera |  | Roadie strafes
4 | Roadie moves forward 4 inches |  | Roadie moves forward
5 | Roadie signles that it has arrived at the challenge |  | Roadie is at the Etch-A-Sketch
Post-conditions: Roadie has aligned with the challenge and signles that it has arrived at the challenge.
Project Name:
Test Case ID: Playing Card Idenfitication and Algiment |  |  |  | Test Design By: Michael Philotoff
Test Priority: High |  |  |  | Test Designed Date: November 30, 2014
Module Name: |  |  |  | Test Excuted By:
Test Title: Correctly Idenfity Playing Card deck |  |  |  | Test Excution Date:
Description: Roadie correctly idenfities the challenge Playing Card deck within 5 seconds of the camera being turn on. Then Roaide algins itself up with Playing Card deck.
Pre-conditions: Roadie has arrvied at a challenge zone and has detected a challenge within 4 inches of Roadie
Requirement Satisfied: COR 6.5, COR 7, and COR 7.1
Step | Test Steps | Test Data | Expected Result | Actual Result | Status(Pass/Fail) | Notes
1 | Camera idenfities Playing Card deck |  | Playing Card deck is identified
2 | Camera measures the distance | Pixels convereted to inches | Distance measured
3 | Strafe the distance measured from the Camera |  | Roadie strafes
4 | Roadie moves forward 4 inches |  | Roadie moves forward
5 | Roadie signles that it has arrived at the challenge |  | Roadie is at the Playing Card deck
Post-conditions: Roadie has aligned with the challenge and signles that it has arrived at the challenge.
