powellb1/CapStone/Documentation/Sprints/Sprint 3/Are We There Yet - Sprint 3 Postmortem.docx

Are We There Yet: Sprint 3 Postmortem

Planning Meeting

During the planning meeting, we constructed a back log from the items listed in the Budget Rubric that still need completing. From there, we assigned a perceived difficulty on a scale of one to five with one being trivial.

Task | Perceived Difficulty
Budget Preparation | 5
Formatting | 4
Requirements Traceability | 4
Parts Order | 2
Begin Prototyping | 3
Risk Analysis | 4

- We found that our research and initial budgets have been going well. We need to pick up the pace a little in order to have a good submission for 10/7
- We discussed what commitments we proposed during our postmortem. We have implemented a plan as to how we will meet our commitments. We also discussed how to improve the quality of our work.
- We discussed what we did wrong. We continue to recognize that we didn’t meet as often as we should.
- We discussed what we did well during the last sprint. We agree that we should try and meet more. We also found that we do need to improve some in the quality of work we have submitted.

Stand up logs

Date | Meeting Highlights
10/2 | - Sprint planning - Responsible for: - Alex: line following sensors, wheels - Brian P.:camera, chassis, claw - Brian S. : DC motor, linear actuator, servo - Michael: Microcontroller, battery
10/3 | New: - Michael: Microcontroller and Batteries progress on equations - Alex: Line Following and Movement progress decision matrices - Brian S: Motors decision matrices - Brian P. : Requirements traceability started for camera Issues: Format needs to consistent across all sections For next meeting: Common format for all sections and risk analysis
10/4 | New: - Michael: Risk analysis done for microcontroller - Alex : Risk analysis done for lin following - Brian S. : Risk analysis done for DC motors - Brian P: Risk analysis done for camera, arm Issues: Make sure deadlines are met. Some sections are behind on their expect progress. For next meeting: All of the budget sections need to be submitted to Brian P. for final assembly.
10/6 | New: All sections (Decision matrix, risk analysis and requirements traceability) have been completed for each component. Issues: Formatting. Formats wildly vary from section to section. All tables need lead ins and captions. For next meeting: Rough draft of budget needs to be done so that revisions can be made before submission on 10/7.
10/7 | New: Budget has been assembled into one document. It needs a lot of reworking in order to be ready for submission tonight. Responsibilities: - Brian P. - Make sure the claw, chassis and camera have equations to show quantitative analysis. Formatting - Michael - Battery calculations need explaining. Make sure all sections of the microcontroller and battery have equations. - Alex - Line following sensors and wheels need calculations. - Brian S. - Decision matrices for linear actuators. Issues: Budget was not prepared in time. We need to learn better.
10/9 | New: We have the ability to re-submit budget. Each member needs to take their section and revise it. Issues: From the initial submission, these need fixing: - Battery calculations need explaining - Page numbers aren’t correct - Consistent captions For next meeting: Have sections ready to go.
10/10 | New: Sections that still need fixing: - Battery - Actuators As a group we’ll go over what needs to be changed in these sections and why. Issues: Need to submit the budget tonight. Needs to be proofread.
10/14 | New: Dole out prototyping responsibilities: - Brain P: computer vision - Michael : Simulate IEEE on Etch-A-Sketch - Alex : Line following - Brian S. : Arm design Issues: No issues to report. For next meeting: Report on initial prototyping research

What Went Well

During Sprint 3, communication amongst our team went well. We all knew when the meeting were and what was to be discussed during the meeting. After the meeting, we all left knowing what needed to be done and when the due date was.

Additionally, our team frequently updated GitHub. This allowed us to all have current documents for editing and revisions. This showed us the progress that had been made, and allowed us to track progress on large tasks. By doing so, it allowed us to better plan for the budget in the coming weeks.

What Could Use Improvement

While we knew that style and format needed improvements from the last sprint, we failed to plan for it in this sprint. For larger documents, we need to plan for common formats and styles during the beginning stages so that merging parts isn’t as much of a hassle.

We managed to iron down meeting times and meet many times during this sprint. There were times however, when we need to realize when a stand-up meeting with a time-box versus a work meeting is necessary as to not waste time.

Although we did plan a schedule for delivering the budget artifact on time, we vastly underestimated the work of formatting and proofreading the entire document. This needs to be considered for future artifacts.

Our Commitments This Next Sprint

Since we have now placed our parts order the next step is the prototyping process. We will each be taking a section of the robot and creating a working prototype in the upcoming sprint. The prototype responsibilities are as follows:

- Brian P. - object recognition/detection
- Michael - Etch-A-Sketch simulation
- Alex - line following
- Brian S. - arm prototype

As prototyping will consume most of the next sprint, it is what we have most of our time allotted to.

Additionally, we will be committed to maintaining our effective communication skills that we exhibited during this sprint. We also need to plan better for what is coming due. This was a large lesson learned, and one that will not soon be forgotten.

Retrospective

Looking back to Sprint 2, we have met most of the commitments that we proposed. During Sprint 2, we began to focus more and hone in on one design, which helped in guiding us towards the correct parts to use. During Sprint 3, we were able to refine the design proposed in Sprint 2 to help with a more concise budget and parts order. The budget and parts order has guided us towards the prototypes that will be needed during this next sprint. This is due to the fact that some of the parts that we had initially thought may work, did not turn out as expected when performing our decision matrices.

As noted in Sprint 2, for the most part, we were able to submit all documents on time and with quality we are proud of. As we noted, we lagged a little with our budget document, but we have learned from this mistake and we will not make that error again. Additionally, we still need to improve meetings. This is especially true as we move into prototyping. This is because as we begin to get into prototyping, we will need to rely on each others skills and abilities more, thereby making the frequency with which we meet an important factor to improve upon.
