powellb1/CapStone/Software/ComputerVision/slidePot_move/Motor_shield_demo_code/Motor_shield_demo_code.ino

//. Motor driver shield- 2012 Copyright (c) Seeed Technology Inc.
// 
//  Original Author: Jimbo.we
//  Contribution: LG
//  
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
int pinI1=8;//define I1 interface
int pinI2=11;//define I2 interface 
int speedpinA=9;//enable motor A
int pinI3=12;//define I3 interface 
int pinI4=13;//define I4 interface 
int speedpinB=10;//enable motor B
int spead =255;//define the spead of motor
 
void setup()
{
  pinMode(pinI1,OUTPUT);
  pinMode(pinI2,OUTPUT);
  pinMode(speedpinA,OUTPUT);
  pinMode(pinI3,OUTPUT);
  pinMode(pinI4,OUTPUT);
  pinMode(speedpinB,OUTPUT);
}
 
void forward()
{
     analogWrite(speedpinA,spead);//input a simulation value to set the speed
     analogWrite(speedpinB,spead);
     //digitalWrite(pinI4,HIGH);//turn DC Motor B move clockwise
     //digitalWrite(pinI3,LOW);
     digitalWrite(pinI2,LOW);//turn DC Motor A move anticlockwise
     digitalWrite(pinI1,HIGH);
}
void backward()//
{
     analogWrite(speedpinA,spead);//input a simulation value to set the speed
     analogWrite(speedpinB,spead);
     //digitalWrite(pinI4,LOW);//turn DC Motor B move anticlockwise
     //digitalWrite(pinI3,HIGH);
     digitalWrite(pinI2,HIGH);//turn DC Motor A move clockwise
     digitalWrite(pinI1,LOW);
}
void left()//
{
     analogWrite(speedpinA,spead);//input a simulation value to set the speed
     analogWrite(speedpinB,spead);
     digitalWrite(pinI4,HIGH);//turn DC Motor B move clockwise
     digitalWrite(pinI3,LOW);
     digitalWrite(pinI2,HIGH);//turn DC Motor A move clockwise
     digitalWrite(pinI1,LOW);
}
void right()//
{
     analogWrite(speedpinA,spead);//input a simulation value to set the speed
     analogWrite(speedpinB,spead);
     digitalWrite(pinI4,LOW);//turn DC Motor B move anticlockwise
     digitalWrite(pinI3,HIGH);
     digitalWrite(pinI2,LOW);//turn DC Motor A move clockwise
     digitalWrite(pinI1,HIGH);
}
void stop()//
{
     digitalWrite(speedpinA,LOW);// Unenble the pin, to stop the motor. this should be done to avid damaging the motor. 
     digitalWrite(speedpinB,LOW);
     delay(1000);
 
}

void loop()
{
  forward();
  delay(1000);
  backward();
  delay(1000);
}
