powellb1/CapStone/(commit log)

2014-09-08 Updated PowerPoint
2014-09-13 Add parts to sequence diagrams
    Also, change some parts to the use case, added bad state and good state
    to the glossary... For the third sequence diagram I cant center it on
    the page maybe you can, I tried cutting it out and pasting it again to
    see if that worked, but it didn't.
2014-09-18 use cases
    add the 6th use case and fixed the other use cases, also added in two
    words to the glossary and edit a few words in the glossary
2014-09-18 use case stakeholder updated
    added in the ECSSE and IEEE to each of the use cases, sequence diagrams
    save file got messed up so I'm rebuild each one of them so I'll have
    then done by noon tomorrow at the latest
2014-09-18 Requirements
    Fixed use case formatting. Changed weird requirements.
2014-09-19 Requirements.
    Added periods to the end of use case sentences.
2014-10-01 Movement budget
    Wheel justifications and decision matrix
2014-10-04 Chassis Budget
    Rough outline of chassis budget. More of a means to get thoughts down.
2014-10-04 batteries and microcontroller updated
    split the batteries into two sections one for motors the other for
    micorcontroller. also added in risk and environment factors for
    batteries. Microcontroller added three tables description, processing
    power, and memory. description still needs to be finished along with
    memory. Also batteries still need finish the desicion matrix and pick
    out batteries for the motors
2014-10-04 Claw Budget
    Added in claw budget. Still needs some refinement. 90% there.
2014-10-05 Claw and Chassis budget.
    Claw budget has been finalized. The chassis budget is missing
    information on the cost of the custom chassis. Tomorrow the requirements
    traceability and the risk analysis sections will be added.
2014-10-05 Claw, Arm and Chassis
    Incremental commit of claw and chassis budgets. The arm budget has all
    the necessary components for merging into final budget.
2014-10-06 Line Following and Movement
    Requirements Traceability added
2014-10-06 Camera and Chassis.
    Camera and chassis are 95% done. Need confirmation from Jorge on some
    questions I asked him before they can be marked as complete. More
    specifically, in the instance where the robot would literally fail
    (camera stops), what do we put as our mitigation plan?
2014-10-06 Motors Budget
    Motor Budget for the steppers and the gearmotors. Still working on
    section for the linear actuator and risk analysis. References and
    pictures in a separate document
2014-10-06 Motor Budget and Pictures and Refernces
    Missing Risk Analysis
2014-10-07 Motor Budget
    Complete motor budget with risk analysis and requirements traceability.
    Added table description below each table. Every table is labeled (Table
    ?) in the text and Table ?: for the table comments
2014-10-07 Final Budget v1
    Initial commit of budget. Still need to add in motors, movement and
    claw. References need to be added as well as pictures. The risk section
    for camera and battery need to be finalized.
2014-10-07 Final budget v2
    Copied over motor section. Formatting still needed. Will resume in the
    morning.
2014-10-07 Final Budget v3
    All pieces are assembled into the final budget. REFERENCES AND PICTURES
    ARE NOT IN THE BUDGET AS OF YET. Major formatting issues have been
    resolved. Motor section and line following section need some tweaking
    still. Additionally, each section will have a summary. This still needs
    to be implemented.
2014-10-07 Final Budget V4
    Camera section is finished. Small formatting changes.
2014-10-07 Budget V6
    Updated budget to include references for chassis, camera and arm.
2014-10-08 Budget updates
    Updated references for claw, chassis and camera.
2014-10-08 Final Budget
    Budget table ready to be plopped into word.
    [Final Budget.xlsx]
2014-10-08 Final Budget Update
    Updated columns and numbers
    [Final Budget.xlsx]
2014-10-08 Updated final budget
    Motors updated. Regerences updated
2014-10-08 Parts order
    Initial commit to github.
    [Parts Order.xlsx]
2014-10-08 Added LiPo Fuel Gauges
    these were the only ones i could find
    [Parts Order.xlsx]
2014-10-08 MotorDriver
    Stepper motor driver added
    [Parts Order.xlsx]
2014-10-09 Budget Doc update
    Updated formatting and spelling of budget doc
    [Parts Order.xlsx]
2014-10-10 Budget update
    Updated battery section of budget.
2014-10-20 Progress report 5
    deals with the prototypes due in a week, also I forgot what Brian S. is
    prototyping so if you could just add that in that would be great
2014-10-26 Adding in CV software. The software includes a CPP file and an Arduino File. The Arduino will accept serial data and react depending upon the information coming in. Once it is done, it sends confirma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
2014-10-27 Linefollow code
    Code updated with PID library and average of QREs.
2014-10-27 PID corrections
    Linefollow software
    [UdooSoftware.ino]
2014-10-31 Software and postmortem grammar
    Software syntax updates as usual along with some short postmortem
    grammar fixes
    [UdooSoftware.ino]
2014-11-03 Sensor array and new basic line following code
    -QTR code is basic sensing code.
    -LineFollowing includes the QTR code plus PID code. pidOutput needs to
    interact with motors.
2014-11-06 3D Parts and Stepper Motor Code
    Added 3D parts for the wheel coupler and wheel cap. Added in sample
    stepper motor code.
    [Wheel_Coupler.ipt, Wheel_Coupler.stl, Wheel_cap.ipt, Wheel_cap.stl]
2014-11-08 Refined 3D Parts
    [Wheel_Coupler.0002.ipt, Wheel_Coupler.dwg, Wheel_Coupler.ipt, Wheel_Coupler.stl, Wheel_cap.0001.ipt, Wheel_cap.ipt, Wheel_cap.stl]
2014-11-09 Adding new changes to Computer Vision that reflect where the camera is mounted on the robot
2014-11-09 3D Part Updates
    Updated the parts for the wheel coupler
    [Wheel_Coupler.0002.ipt, Wheel_Coupler.0003.ipt, Wheel_Coupler.ipt, Wheel_Coupler.stl]
2014-11-10 3D Parts Update
    Updated 3D parts to reflect width changes,
    [Wheel_Coupler.0003.ipt, Wheel_Coupler.0005.ipt, Wheel_Coupler.ipt, Wheel_Coupler.stl, Wheel_cap.0001.ipt, Wheel_cap.0003.ipt, Wheel_cap.ipt, Wheel_cap.stl]
2014-11-12 Update to last working Object Detection
    Uploading working camera code
2014-11-13 Committing updated contours and arduino sketch. Ardunio sketch works with range sensor and turning off camera. Will test tomorrow with motor shield.
2014-11-13 Late code changes
    Line following code includes additions for stepper integration.
2014-11-13 Post Mortem 5
    Uploaded post mortem 5.
    [Wheel_Coupler.0005.ipt, Wheel_Coupler.0006.ipt, Wheel_Coupler.ipt, Wheel_Coupler_2.stl]
2014-11-14 Fixed momemnts_cam_demo.cpp so that it will compile on Pi.
    [objectDetection.ino]
2014-11-15 Uploaded working range and image detection. The arduino can correctly sense when an image is near. It communicates to the Pi once the challenge is complete to turn off the camera.
    [objectDetection.ino]
2014-11-15 Added in turning and auto correction
    [LineFollowing.ino]
2014-11-16 Vision software successfully talks to the arduino to turn the camera off and on as well as to shuffle.
2014-11-16 Camera software works. It is ready to go for integration tomorrow. Working on turning Arduino code into a library for ease of use.
2014-11-17 Arduino Libraries
    Created an object detect library for Arduino for ease of implementation.
    [Part1.ipt, Part1.stl]
2014-11-18 Prototype 2
    Added in prototype 2 report.
2014-11-22 Level 2 Requirements
    Challenge and Movement Systems need their traceability matrices
    completed. All sections need sequence diagrams. Challenge and movement
    systems need use cases. Challenge and movement systems also might need
    more requirements.
2014-11-24 LineFollowing Code
    New code includes Mike's movement code. The script uses leftSideSpeed
    and rightSideSpeed static global variables to utilize the PID outputs.
2014-11-24 Level 2 Requirements
    Added traceability matrices for movement and challenges
2014-11-24 Level 2 Requirements
    Made some format changes. Grammar fix for traceability matrices
2014-11-25 Use cases updated
    Redid the use case from the challenge section and added in use case from
    the movement section.
2014-11-25 updated the extentsions and removed the full movement use case
    Removed the full movement use case because there is already one located
    in section 4.
2014-11-25 Common Libraries and Strafe code
    Strafe script added that includes function to strafe based off inches
    provided.
    Common Libraries folder added so we're all on the same page. Currently
    includes AFMotor, AccelStepper, QTRSensors, and PID
    [project.cfg]
2014-11-29 Test case stuff
    [TestCaseTemp.xlsx]
2014-11-30 Extended wheel caps
    [Wheel_cap_extended.0001.ipt, Wheel_cap_extended.ipt]
2014-11-30 uploading test case stuff
    [TestCaseTemp.xlsx]
2014-11-30 Design Document
    Added in System Design diagram as well as completed most of system
    overview. Need to finish system design.
    [Responsibilities.xlsx]
2014-11-30 First Movement/Misc Tests
    [Movement-Misc_TestCases.xlsx]
2014-11-30 coordination system test cases
    not finished
    [Coordination_TestCases.xlsx]
2014-12-02 Design Document
    Changed system design around.
    [Responsibilities.xlsx]
2014-12-02 Movement/Misc Test cases
    Movement and misc test cases should be complete. All movement
    requirements covered along with many lower level tests.
    [Movement-Misc_TestCases.xlsx]
2014-12-02 SDS quick edit
    Just quick things that popped out. No major changes.
    [TestCaseTemp.xlsx]
2014-12-03 STL Files for 3D Part
    Added in STL file for new wheel caps
    [Wheel_cap_extended.stl]
2014-12-03 Design Document
    Added in a few descriptions to function flow.
    [Responsibilities.xlsx]
2014-12-03 Challenge zone test cases
    Might need a few more to if I or someone else thinks of more test cases
    [Challenge_TestCases.xlsx]
2014-12-03 quick example test case layout in word
    working with converting tables from excel to word.
2014-12-03 updated progress
    [Responsibilities.xlsx]
2014-12-04 testplan update
    [Challenge_TestCases.xlsx, Coordination_TestCases.xlsx]
2014-12-04 Movement-Misc TestCases format updated
    [Movement-Misc_TestCases.xlsx]
2014-12-04 Testplan Updated
    -fixed some errors
    -added in references to all of the test case
2014-12-04 SDS with the added circuit diagrams
    Sorry fell behind with other projects, this update has all the circuit
    diagrams, will try to get the CAD images for the hardware and pictures
    for interfaces early tomorrow
2014-12-04 Requirement Trace in Parts Budget
2014-12-04 Design Document
    Updated the requirements trace for design document.
2014-12-05 added test cases
    added in bad value test cases
    added veer left test case
2014-12-08 Changed LF logic; Changed PID Outputs in Library
    test
2014-12-08 LF bug fix
    Strafing code also changed for testing purposes.
    [Strafeing.ino, _23NOV_LineFollowing.ino]
2014-12-09 Design Presentation
    Quick design presentation fixes
    [Strafeing.ino]
2014-12-09 updated line code
    fixed some of the logic that would never get invoked
    and edited the speeds
    [_23NOV_LineFollowing.ino]
2014-12-09 updated linefollowing
    change the analog pin numbers
2014-12-09 Powerpoint Update
    LF following increment adjustments
2014-12-10 Homemade PID
    Needs work,but uses individual sensors and error values rather than a library.
    [LineFollow_ownPID.ino]
